sbellem/dabao/dabao_v3c.kicad_pcb

## KiCad design dabao_v3c.kicad_pcb (2026-02-27)

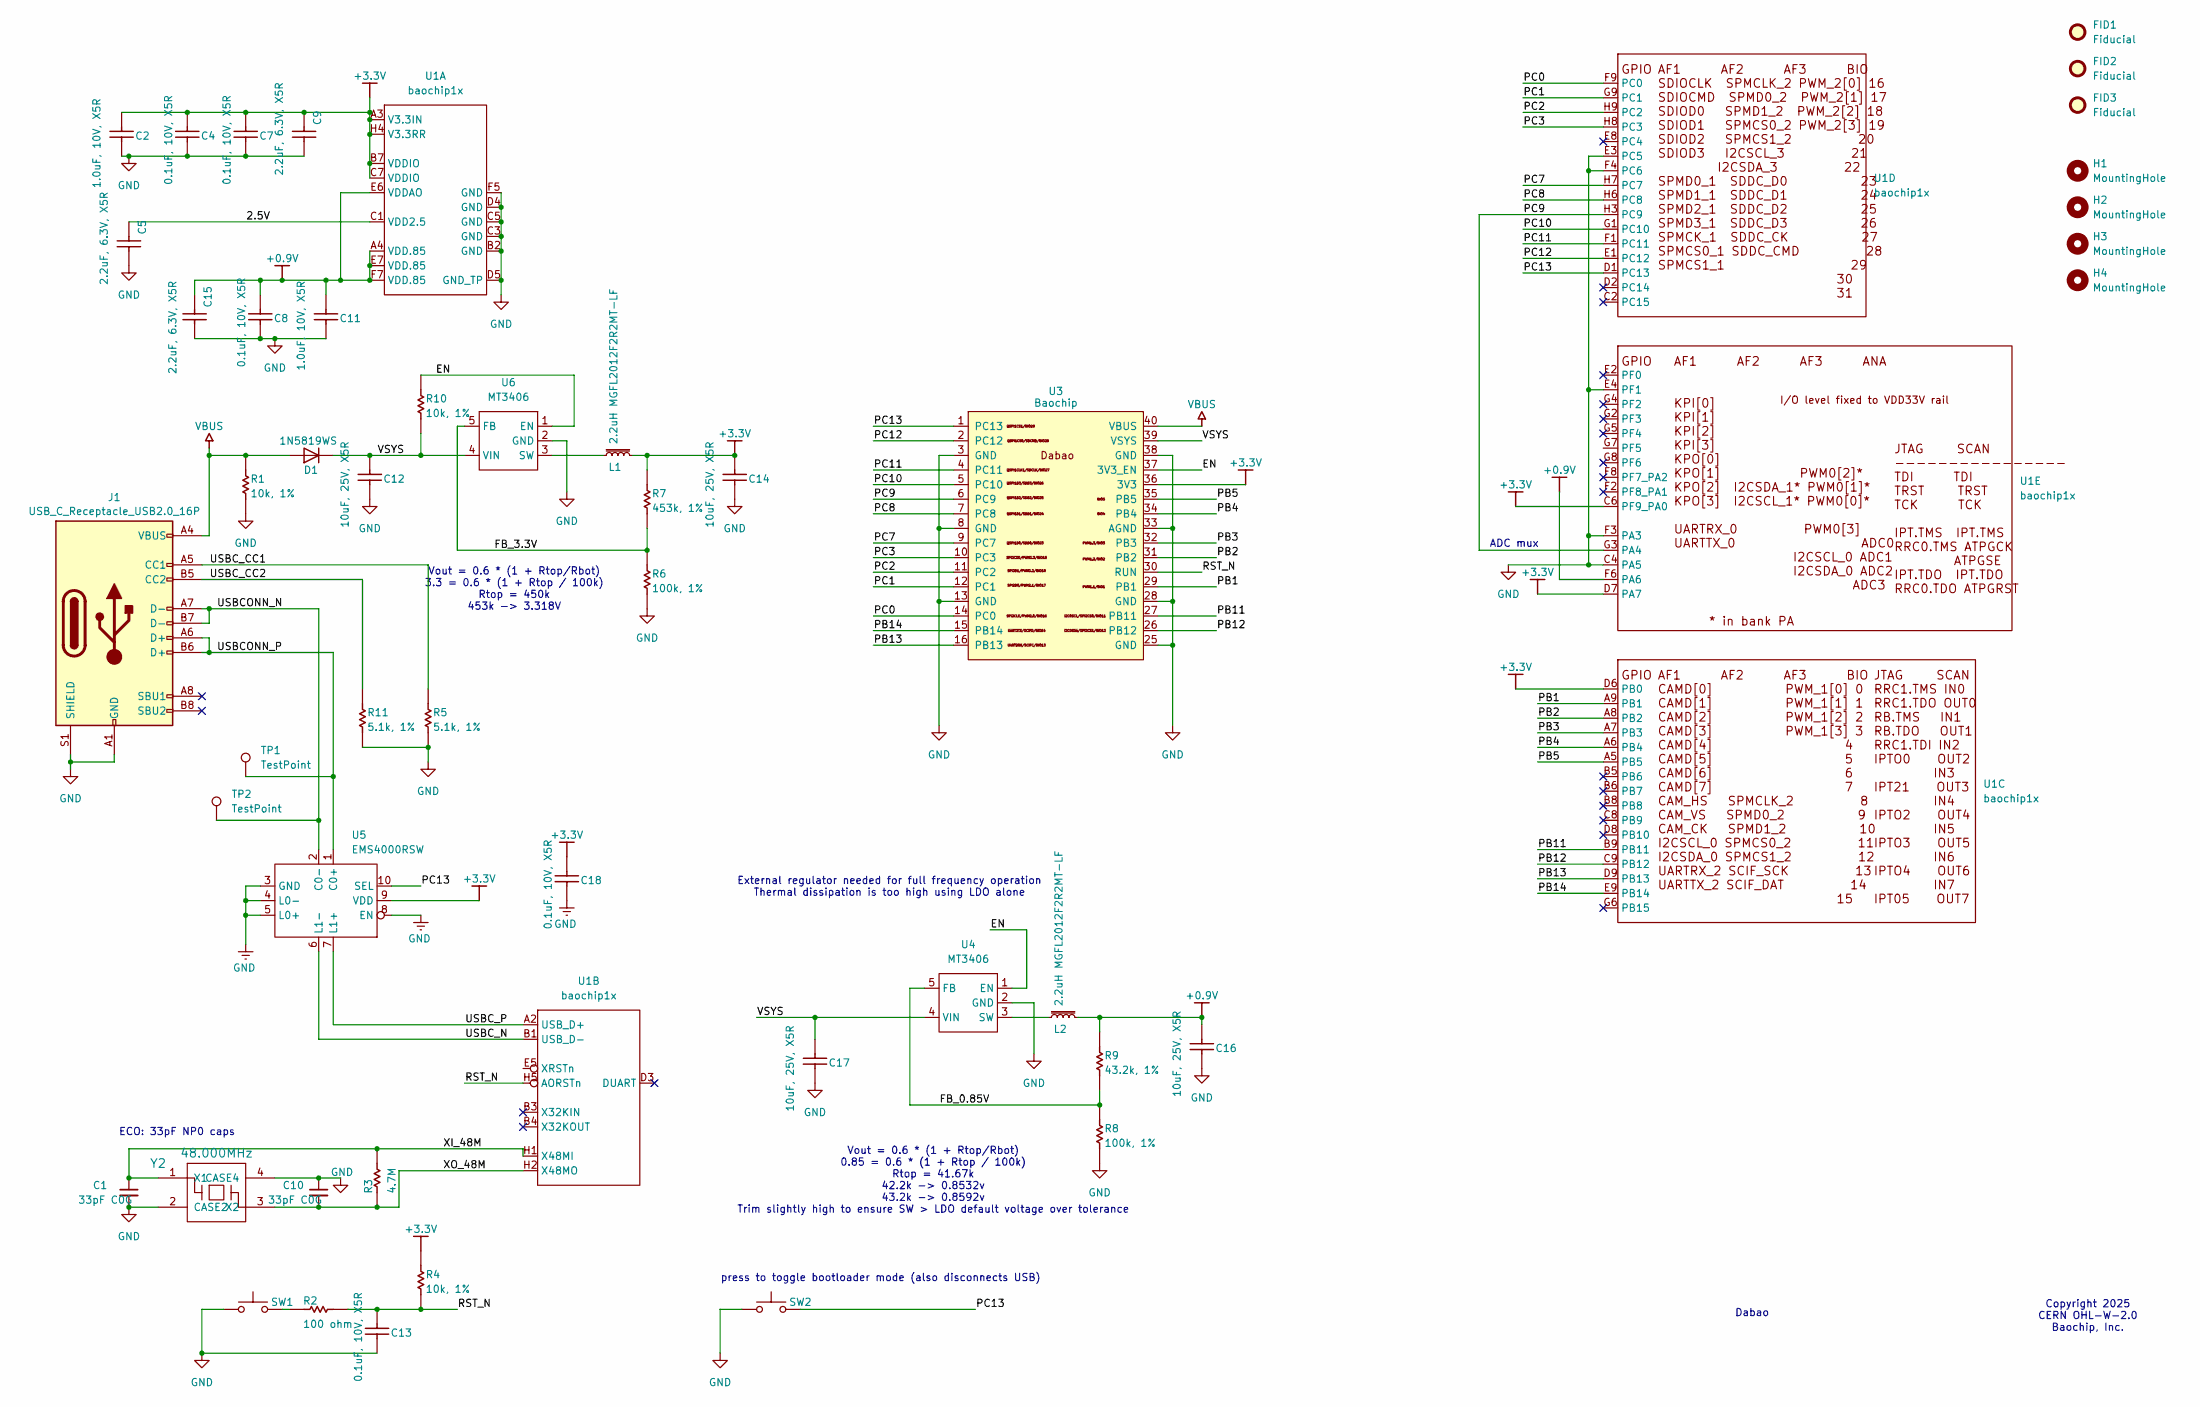
[picture p3: schematic dabao_v3c.kicad_sch]

Parts:
C1, C10: 33pF C0G; C_0201_0603Metric; LCSC C56903
C2, C11: 1.0uF, 10V, X5R; C_0201_0603Metric; MPN CL05A105KA5NQNC; LCSC C76935
C4, C7, C8, C13, C18: 0.1uF, 10V, X5R; C_0201_0603Metric; MPN CL05B104KO5NNNC; LCSC C76934
C5, C9, C15: 2.2uF, 6.3V, X5R; C_0201_0603Metric; MPN GRM033R60J225ME47D; LCSC C76933
C12, C14, C16, C17: 10uF, 25V, X5R; C_0603_1608Metric; MPN CL10A106MA8NRNC; LCSC C96446
D1: 1N5819WS; D_SOD-323; MPN SD103AWS; LCSC C191023
FID1, FID2: Fiducial; IRIS fiducial 0.4mm
FID3: Fiducial; IRIS fiducial2 0.4mm
H1, H2, H3, H4: MountingHole; MountingHole_2.2mm_M2_DIN965
J1: USB_C_Receptacle_USB2.0_16P; USB_C_Receptacle_HRO_TYPE-C-31-M-12; LCSC C165948
L1, L2: 2.2uH MGFL2012F2R2MT-LF; L_0805_2012Metric; LCSC C281115
R1, R4, R10: 10k, 1%; R_0201_0603Metric; MPN ANY; LCSC C106225
R2: 100 ohm; R_0402_1005Metric; MPN ANY; LCSC C106232
R3: 4.7M; R_0402_1005Metric; MPN ANY; LCSC C474132
R5, R11: 5.1k, 1%; R_0402_1005Metric; MPN ANY; LCSC C25905
R6, R8: 100k, 1%; R_0201_0603Metric; MPN ANY; LCSC C106224
R7: 453k, 1%; R_0201_0603Metric; MPN ANY; LCSC C423509
R9: 43.2k, 1%; R_0201_0603Metric; MPN ANY; LCSC C158519
SW1, SW2: SW_Push; SW_Push_1P1T_XKB_TS-1187A; MPN TS-1187A-B-B-B; LCSC C528026
TP1, TP2: TestPoint; TestPoint_Pad_D1.0mm
U1: baochip1x; WLCSP-71_9x8_4.062x3.762mm
U3: Baochip; Dabao_Vendor_Substrate
U4, U6: MT3406; SOT-23-5; LCSC C22462728
U5: EMS4000RSW; QFN-10_1.4x1.8_Pitch0.4mm; LCSC C49186227
Y2: 48.000MHz; Crystal_SMD_3225-4Pin_3.2x2.5mm; LCSC C2892060

Connections:
+0.9V: C8.1, C11.1, C15.1, C16.1, L2.2, R9.1, U1.A4 (VDD.85), U1.E6 (VDDAO), U1.E7 (VDD.85), U1.F6 (PA6), U1.F7 (VDD.85)
+3.3V: C2.1, C4.1, C7.1, C9.1, C14.1, C18.1, L1.2, R4.1, R7.1, U1.A3 (V3.3IN), U1.B7 (VDDIO), U1.C6 (PF9_PA0), U1.C7 (VDDIO), U1.D6 (PB0), U1.D7 (PA7), U1.H4 (V3.3RR), U3.36 (3V3), U5.9 (VDD)
/2.5V: C5.1, U1.C1 (VDD2.5)
/EN: R10.1, U3.37 (3V3_EN), U4.1 (EN), U6.1 (EN)
/FB_0.85V: R8.1, R9.2, U4.5 (FB)
/FB_3.3V: R6.1, R7.2, U6.5 (FB)
/PB1: U1.A9 (PB1), U3.29 (PB1)
/PB2: U1.A8 (PB2), U3.31 (PB2)
/PB3: U1.A7 (PB3), U3.32 (PB3)
/PB4: U1.A6 (PB4), U3.34 (PB4)
/PB5: U1.A5 (PB5), U3.35 (PB5)
/PB11: U1.B9 (PB11), U3.27 (PB11)
/PB12: U1.C9 (PB12), U3.26 (PB12)
/PB13: U1.D9 (PB13), U3.16 (PB13)
/PB14: U1.E9 (PB14), U3.15 (PB14)
/PC0: U1.F9 (PC0), U3.14 (PC0)
/PC1: U1.G9 (PC1), U3.12 (PC1)
/PC2: U1.H9 (PC2), U3.11 (PC2)
/PC3: U1.H8 (PC3), U3.10 (PC3)
/PC7: U1.H7 (PC7), U3.9 (PC7)
/PC8: U1.H6 (PC8), U3.7 (PC8)
/PC9: U1.G3 (PA4), U1.H3 (PC9), U3.6 (PC9)
/PC10: U1.G1 (PC10), U3.5 (PC10)
/PC11: U1.F1 (PC11), U3.4 (PC11)
/PC12: U1.E1 (PC12), U3.2 (PC12)
/PC13: SW2.2, U1.D1 (PC13), U3.1 (PC13), U5.10 (SEL)
/RST_N: C13.1, R2.2, R4.2, U1.H5 (AORSTn), U3.30 (RUN)
/USBCONN_N: J1.A7 (D-), J1.B7 (D-), TP2.1, U5.2 (C0-)
/USBCONN_P: J1.A6 (D+), J1.B6 (D+), TP1.1, U5.1 (C0+)
/USBC_CC1: J1.A5 (CC1), R5.2
/USBC_CC2: J1.B5 (CC2), R11.2
/USBC_N: U1.B1 (USB_D-), U5.6 (L1-)
/USBC_P: U1.A2 (USB_D+), U5.7 (L1+)
/VSYS: C12.1, C17.1, D1.1 (K), R10.2, U3.39 (VSYS), U4.4 (VIN), U6.4 (VIN)
/XI_48M: C1.1, R3.2, U1.H1 (X48MI), Y2.1 (X1)
/XO_48M: C10.2, R3.1, U1.H2 (X48MO), Y2.3 (X2)
GND: C1.2, C2.2, C4.2, C5.2, C7.2, C8.2, C9.2, C10.1, C11.2, C12.2, C13.2, C14.2, C15.2, C16.2, C17.2, C18.2, J1.A1 (GND), J1.A12 (GND), J1.B1 (GND), J1.B12 (GND), J1.S1 (SHIELD), R1.2, R5.1, R6.2, R8.2, R11.1, SW1.1, SW2.1, U1.B2 (GND), U1.C3 (GND), U1.C4 (PA5), U1.C5 (GND), U1.D4 (GND), U1.D5 (GND_TP), U1.E3 (PC5), U1.E4 (PF1), U1.F3 (PA3), U1.F4 (PC6), U1.F5 (GND), U3.3 (GND), U3.8 (GND), U3.13 (GND), U3.25 (GND), U3.28 (GND), U3.33 (AGND), U3.38 (GND), U4.2 (GND), U5.3 (GND), U5.4 (L0-), U5.5 (L0+), U5.8 (EN), U6.2 (GND), Y2.2 (CASE2), Y2.4 (CASE4)
unnamed: R2.1, SW1.2
unnamed: L2.1, U4.3 (SW)
unnamed: L1.1, U6.3 (SW)
VBUS: D1.2 (A), J1.A4 (VBUS), J1.A9 (VBUS), J1.B4 (VBUS), J1.B9 (VBUS), R1.1, U3.40 (VBUS)

Notes on the sheet:
Vout = 0.6 * (1 + Rtop/Rbot) 3.3 = 0.6 * (1 + Rtop / 100k) Rtop = 450k 453k -> 3.318V
ADC mux
External regulator needed for full frequency operation Thermal dissipation is too high using LDO alone
Copyright 2025 CERN OHL-W-2.0 Baochip, Inc.
Dabao
ECO: 33pF NP0 caps
press to toggle bootloader mode (also disconnects USB)
Vout = 0.6 * (1 + Rtop/Rbot) 0.85 = 0.6 * (1 + Rtop / 100k) Rtop = 41.67k 42.2k -> 0.8532v 43.2k -> 0.8592v Trim slightly high to ensure SW > LDO default voltage over tolerance

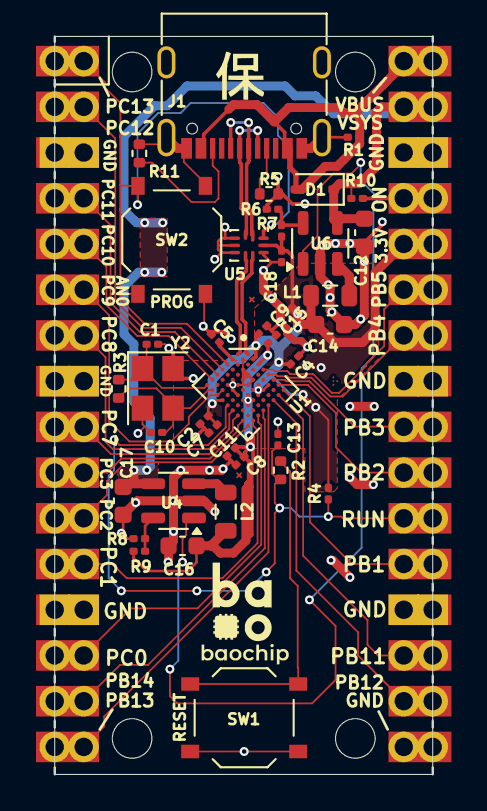
[picture p4: board dabao_v3c.kicad_pcb from above]

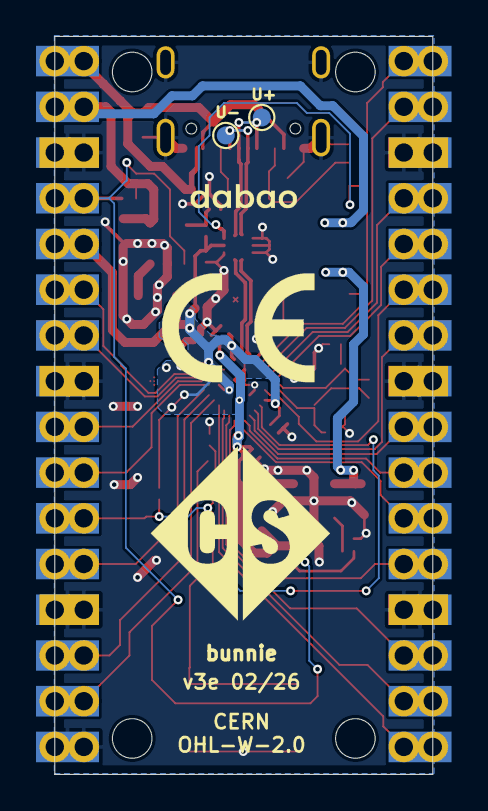
[picture p5: board dabao_v3c.kicad_pcb from below]

Board: 2 copper layers, 21.0 x 41.0 mm, 48 parts (2 on the bottom side), 41 nets.
