sbellem/dabao/(commit log)

2026-02-02 adding sd card and ADC under development
    [pins.csv]
2026-02-02 fixing the incomplete rebase
    [pins.csv]
2026-02-03 visual streamlining, slightly more even board
2026-02-03 sightly nicer board
2026-02-27 update to production release files
    add CE/CS logos
    [bom.csv, dabao_v3c.kicad_pcb, dabao_v3c.kicad_sch]
2026-02-27 update after merge
    [bom.csv, dabao_v3c.kicad_sch]
