sbellem/dabao/(notices)

Notices in the files:
docs/pinout/index.html:
This file was taken from https://github.com/pinout-xyz/pico.pinout.xyz under MIT license.
